steveh78/Upper-Limb-Rehabilitation-Robot/README.md

# ⚙️ Upper limb rehabilitation robot

#### It is a rehabilitation robot for upper limb strength training, specifically rotational and translational movements.

<br> 

## File description

- 📂 firmware : stm32 project files, program manual(korean)
- 📂 hardware : circuit diagram, hardware manual(korean)

<br>

## Overview of research and development
### 1. Introduction
- Upper limb strength training is important for daily life and conservative treatment for patients with spinal cord injuries.
- Rotational exercises strengthen the muscles for wheelchair handling.
- Translational exercises strengthen the pushing and pulling muscles necessary for daily activities.

### 2. Design of mechanical parts
- Mechanism layout
mechanism

### 3. Design of controller
- Block diagram
blockdiagram

- Circuit diagram [hardware](https://github.com/steveh78/Upper-Limb-Rehabilitation-Robot/blob/main/hardware/circuit_diagram.pdf)

circuit

### 4. Control program development
- Function : It consists of 2 exercise modes, 2 option modes, and 3 levels.

|exercise mode|option mode|level|
| --- | --- | --- |
| Rotational | Active-assist | 1, 2, 3 |
| Rotational | Resist | 1, 2, 3 |
| Translational | Active-assist | 1, 2, 3 |
| Translational | Resist | 1, 2, 3 |

- Exercise modes : Rotational and Translational exercise mode
exercisemodes

- Active-assist mode : It operates a motor to assist with exercise. It can also be used for muscle relaxation.
- Resist mode : It uses a motor to generate physical load for muscle strengthening.
- Levels : Exercise intensity can be adjusted in three levels : low(1), medium(2), and high(3).

#### 1. Rotational Active-assist mode
- Controls the position of the AC servo motor by inputting a pulse signal into the AC servo amplifier.
- It waits in a stationary state, and the motor rotates when a value exceeding a certain threshold is measured by the torque sensor.
- If the torque value is high, it indicates that the user is pushing with force, so the position is moved further.
- If the torque value is below a certain threshold, it returns to a stationary state.
- The threshold is set differently depending on the level.

#### 2. Rotational Resist mode 
- It applies the DAC (Digital-to-Analog Converter) voltage to the AC servo amplifier to control the motor current and generate a load.
- The load is set differently depending on the level.
- If a high load is required, use a magnetic brake to generate additional load.
- To prevent the motor from returning to the origin, clear the position deviation to change the origin.

#### 3. Translational Active-assist mode 
- It waits in a stationary state, and the actuator operates when the force sensor measures a value exceeding the threshold.
- The threshold is set differently depending on the level.
translation

#### 4. Translational Resist mode 
- Like Active-assist, it operates the linear actuator by detecting the reaction force applied to the load cell.
- The force threshold and load are set differently depending on the level.
- If the current applied to the motor is high, the load is reduced, making it easier for the user to move. 
- Conversely, if the applied current is low, the load increases, making movement difficult.
<br>

## Result
### 1. Mechanical and electrical parts
prototype

### 2. Control program demonstration
- Rotational exercise

https://github.com/user-attachments/assets/485c6ffb-251e-47c3-863d-0abb0da30623

- Translational exercise

https://github.com/user-attachments/assets/796c5b0c-4be0-4acf-b622-3749bd903251
