steveh78/Upper-Limb-Rehabilitation-Robot/hardware/circuit_diagram.pdf

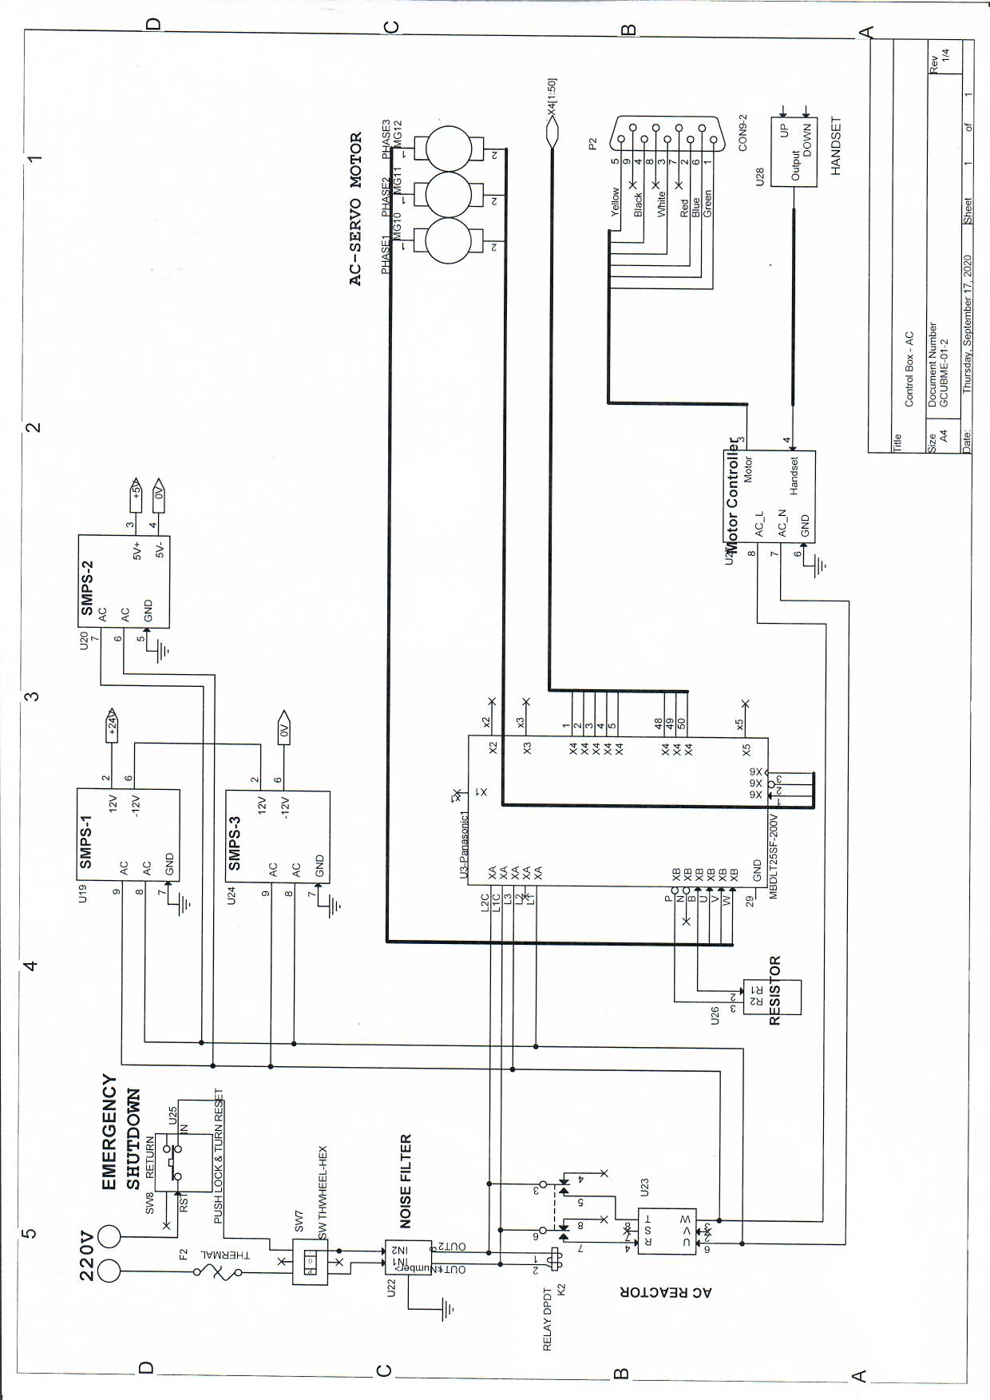
[picture p1: page 1]
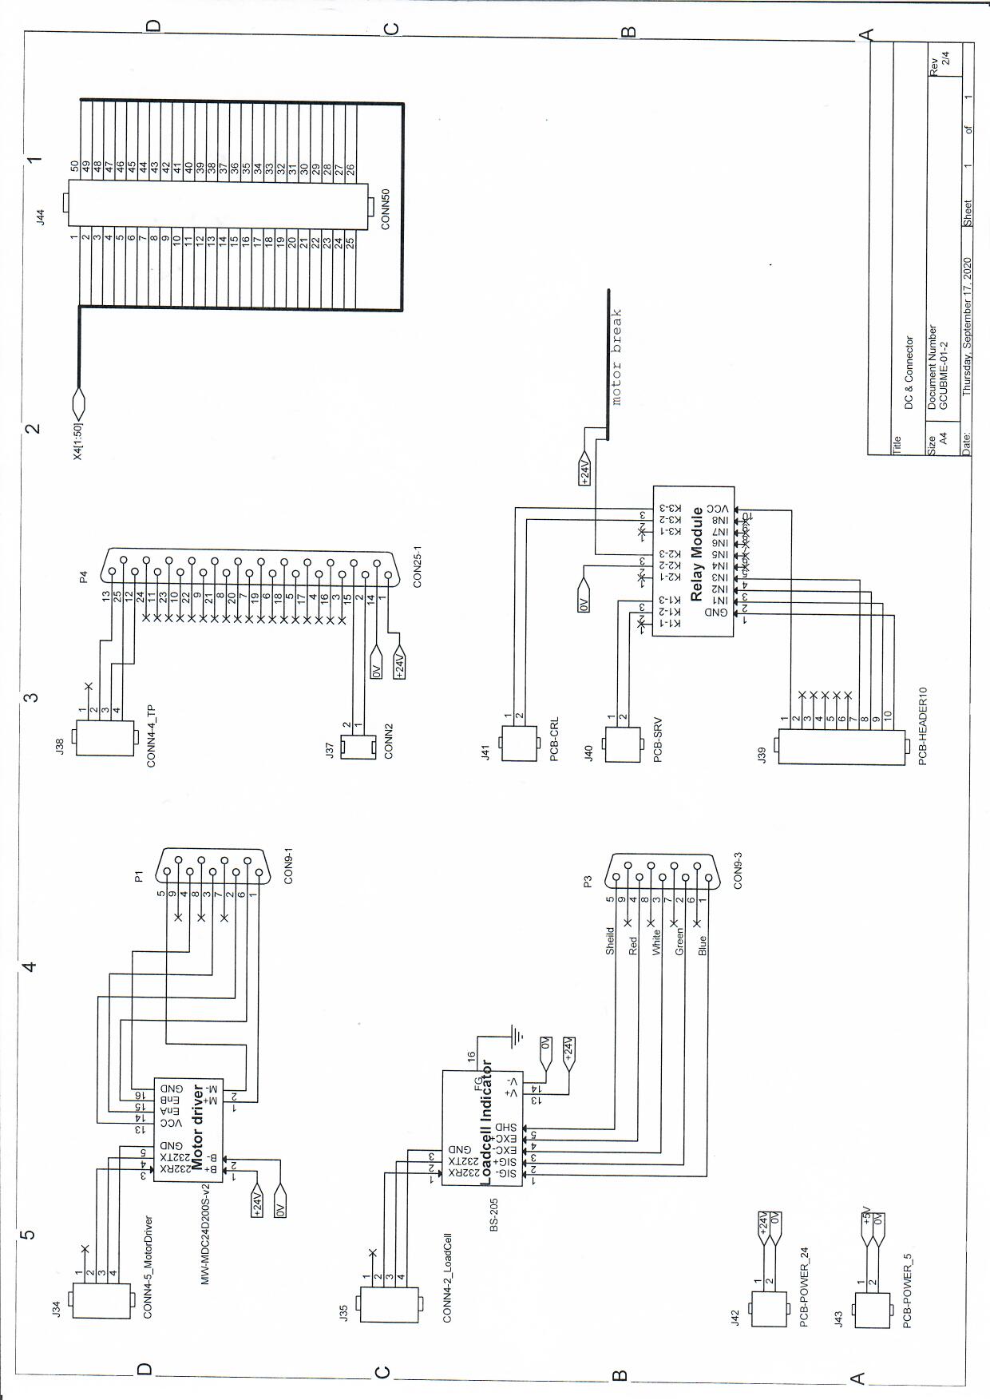
[picture p2: page 2]
