steveh78/Upper-Limb-Rehabilitation-Robot/hardware/hardware_manual_korean.pdf

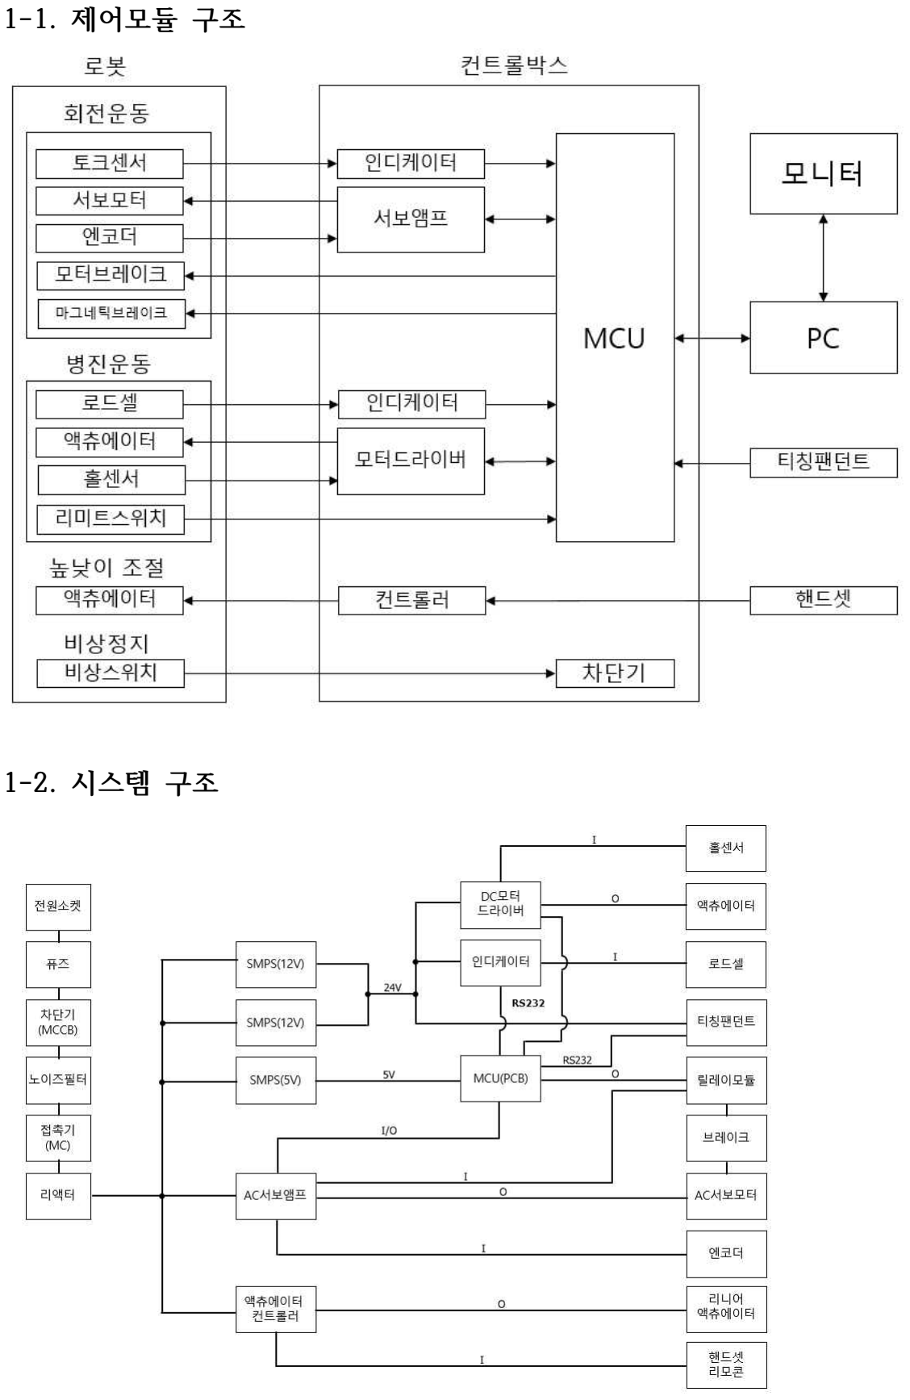
[picture p3: page 1]

### 1-1. 제어모듈 구조

### 1-2. 시스템 구조

### 2. 제작부품 목록

품목 | 모델명 | 규격 | 수 량 | 용도
배선용차단기 | ABE33Fb | 10A / 3P | 1 | 과전류차단
전자접촉기 | DMC22b | AC220V, 20A / 1a1b | 1 | 회로개폐
비상스위치 | PR-25ER | 25파이 | 1 | 비상스위치
소켓 | SS-120BEL | AC250V, 10A / 40*27 | 1 | 전원케이블 연결
퓨즈 | FA-02H | 10A / 5*20 | 1 | 퓨즈
SMPS(5V) | UP50DAA | 50W, DC5V, 8A | 1 | DC 5V
SMPS(12V) | S-350W-12V | 350W, DC12V | 2 | DC 12V, DC 24V
릴레이 모듈 | SZH-RLBG-009 | 8ch / DC5V | 1 | 회로개폐
마이크로컨트롤러 | NUCLEO-F429ZI | Cortex M4 / 180MHz / 144pin | 1 | 모듈 제어
티칭팬던트 | DTP3 | | 1 | 사용자 I/F
AC서보모터 | MSMF042L1T2 | A6, 400W | 1 | 회전운동
AC서보앰프 | MBDLT25SF | A6, AC 250V | 1 | 서보모터 제어모듈
회생저항기 | MCRA-100 | 100W | 1 | 모터과부하 방지
리액터 | WYACR2-0.75 | 400W, AC200V | 1 | 고조파 방지
노이즈필터 | WYNF-S06T2M | AC250V, 6A | 1 | 노이즈필터
리니어액츄에이터 | TA2P | DC24V / 4A(max) / 300mm stroke | 2 | 병진운동
컨트롤러 | TC2B | AC220V, 30A | 1 | 높낮이조절 리모콘
모터드라이버 | MW-MDC24D200 D | 10A / 8~30A | 1 | 리니어액츄에이터 제어모듈
로드셀 | DBBP-50 | 50kg(max) | 1 | 압력측정
인디케이터 | BS-205 | DC24V, RS232 | 1 | ADC, 측정값 전송
회전토크센서 | BRDM-N-100 | 100Nm(max) | 1 | 토크측정
인디케이터 | BS-3520 | AC220V, RS232 | 1 | ADC, 측정값 전송

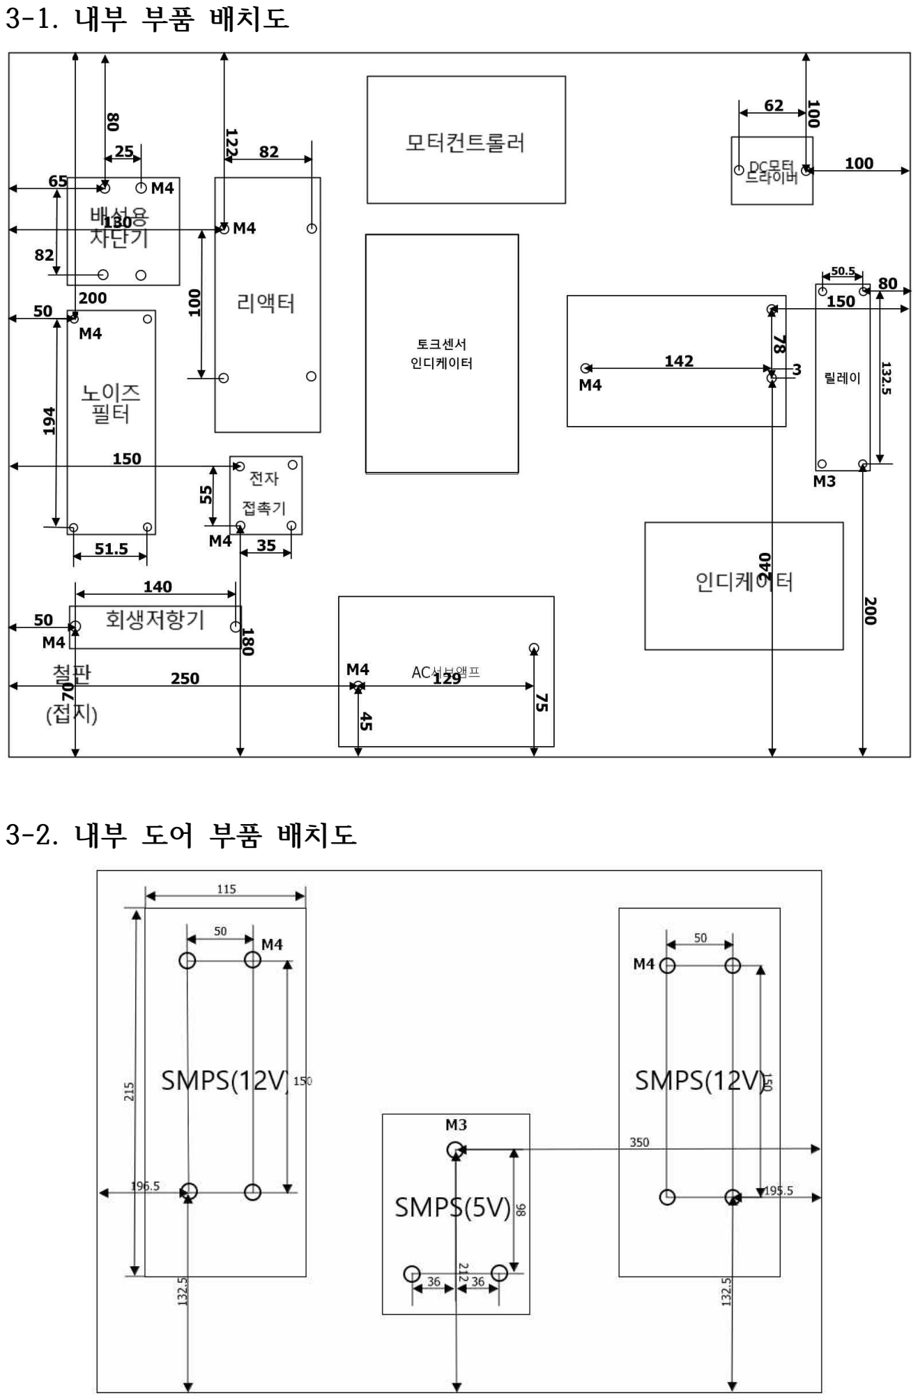
[picture p4: page 3]

### 3-1. 내부 부품 배치도

### 3-2. 내부 도어 부품 배치도

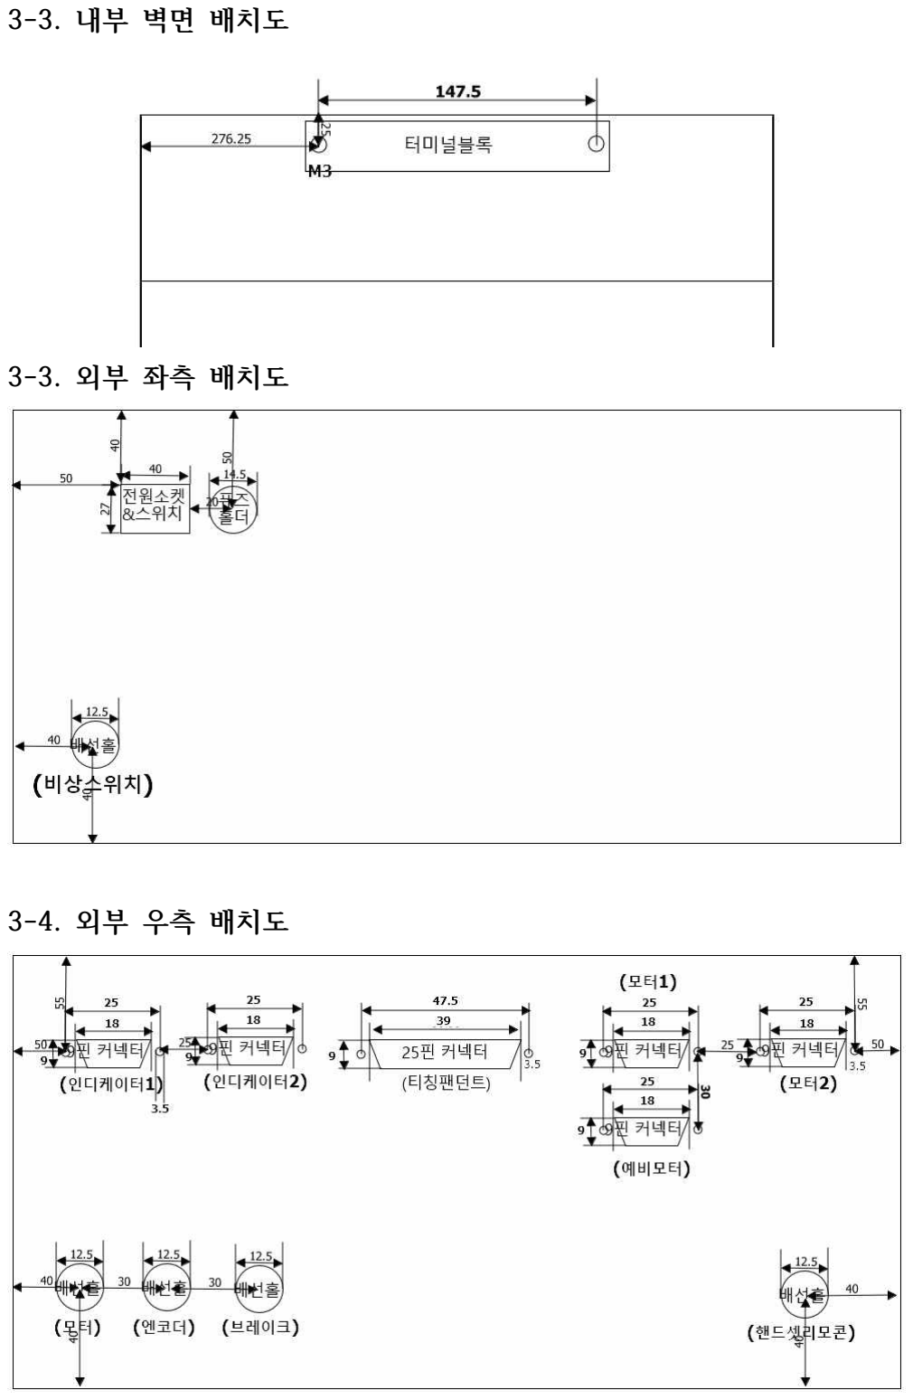
[picture p5: page 4]

### 3-3. 내부 벽면 배치도

### 3-3. 외부 좌측 배치도

### 3-4. 외부 우측 배치도

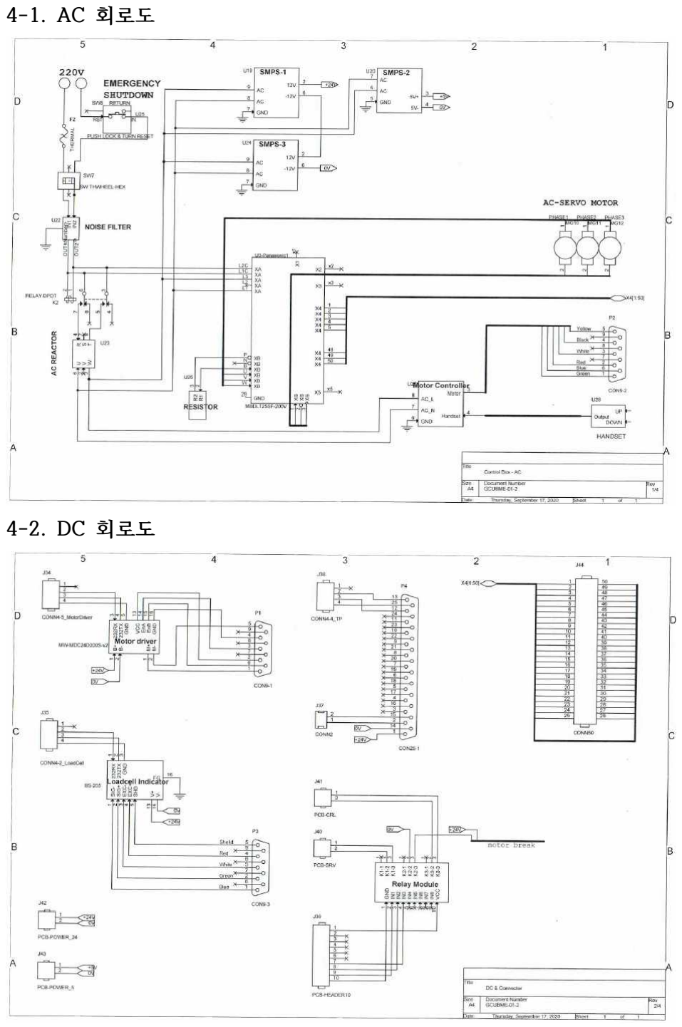
[picture p6: page 5]

### 4-1. AC 회로도

### 4-2. DC 회로도

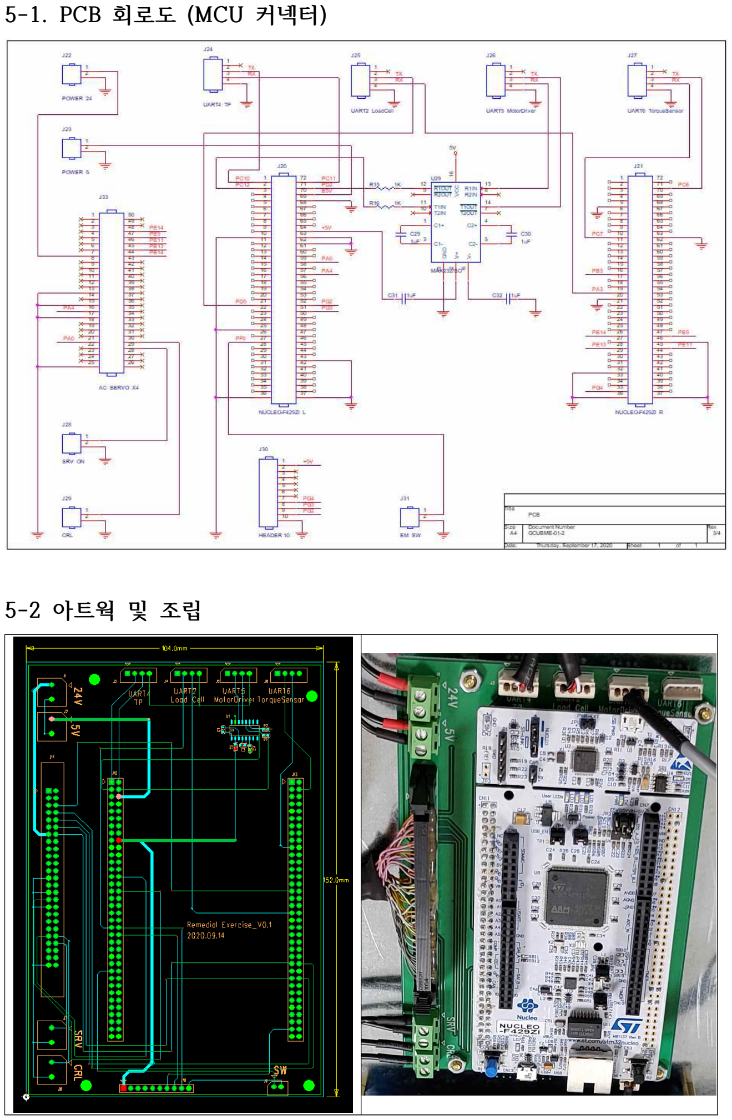
[picture p7: page 6]

### 5-1. PCB 회로도 (MCU 커넥터)

### 5-2 아트웍 및 조립

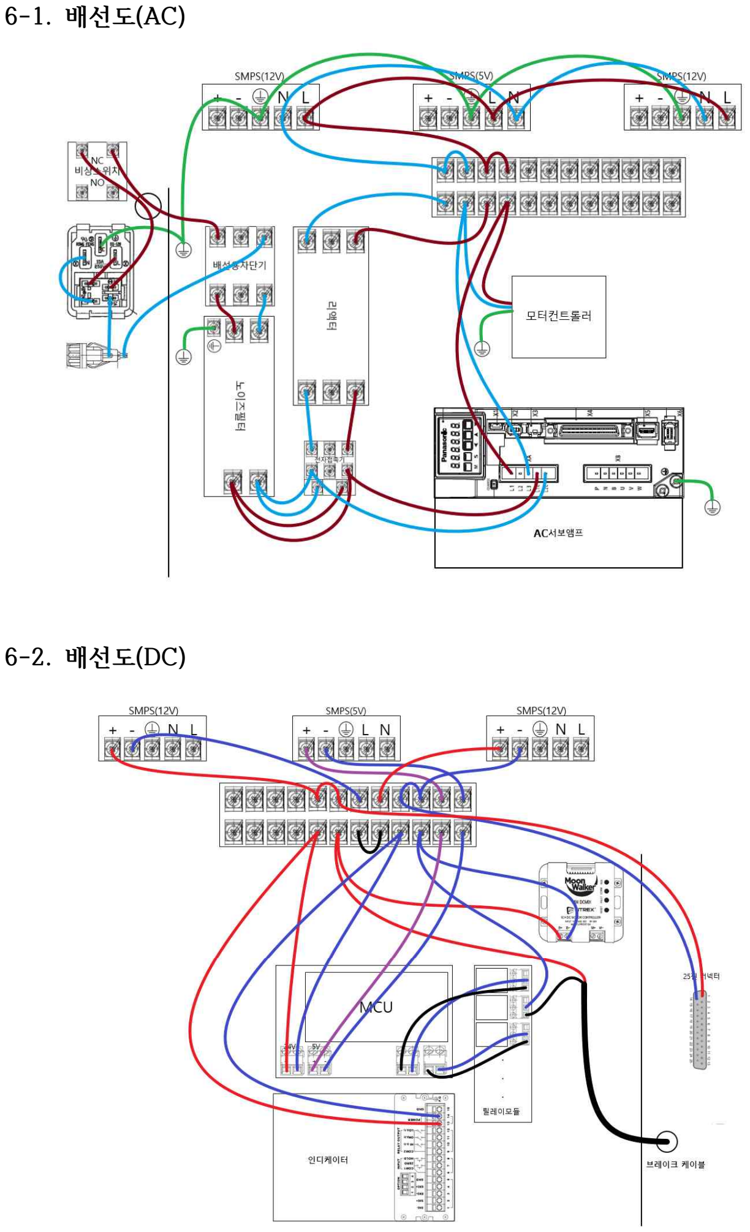
[picture p8: page 7]

### 6-1. 배선도(AC)

### 6-2. 배선도(DC)

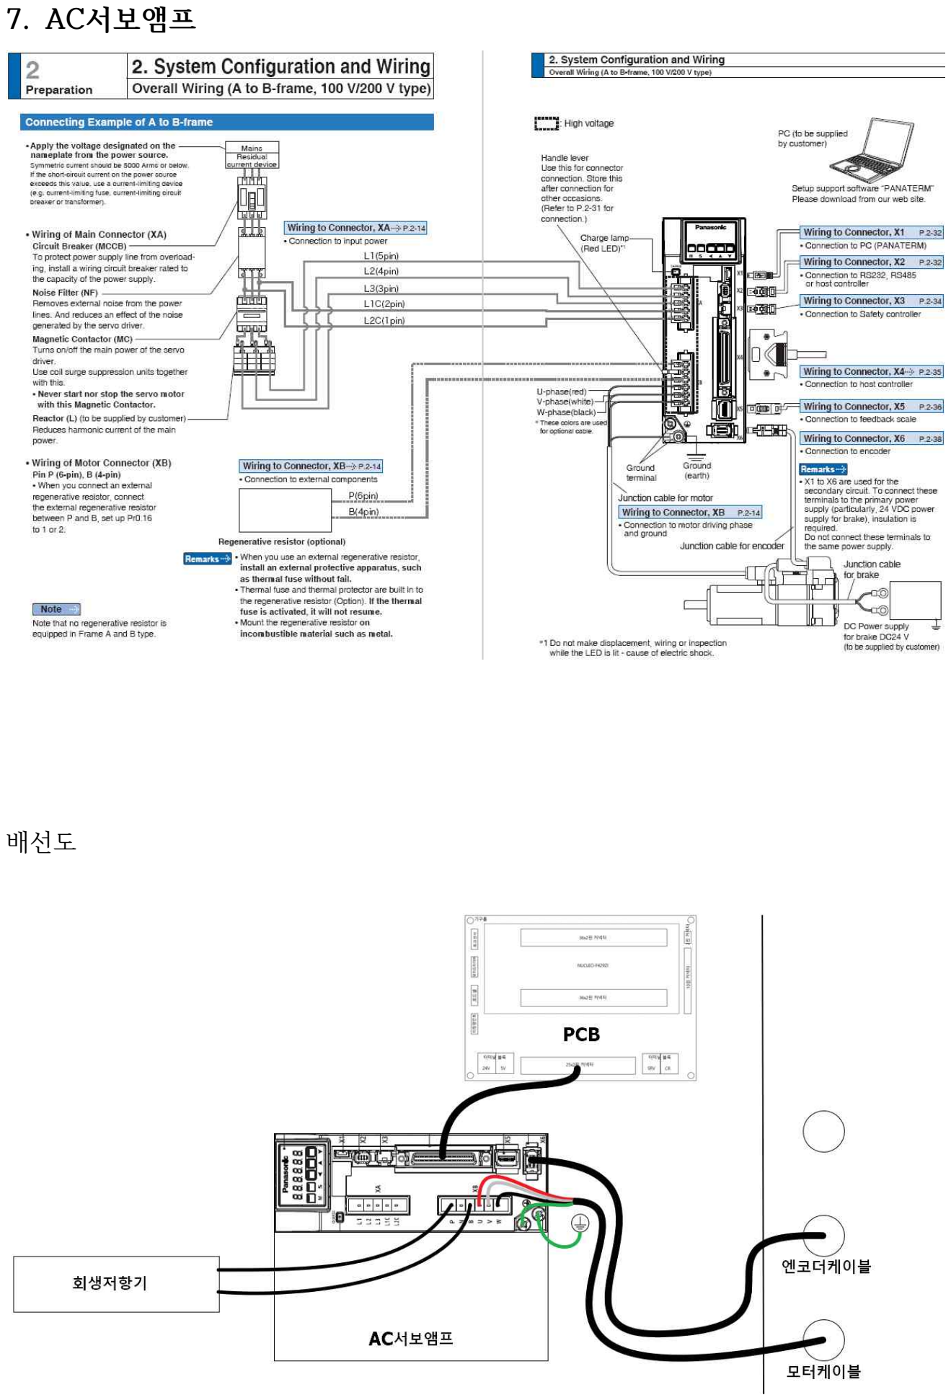
[picture p9: page 8]

### 7. AC서보앰프

배선도

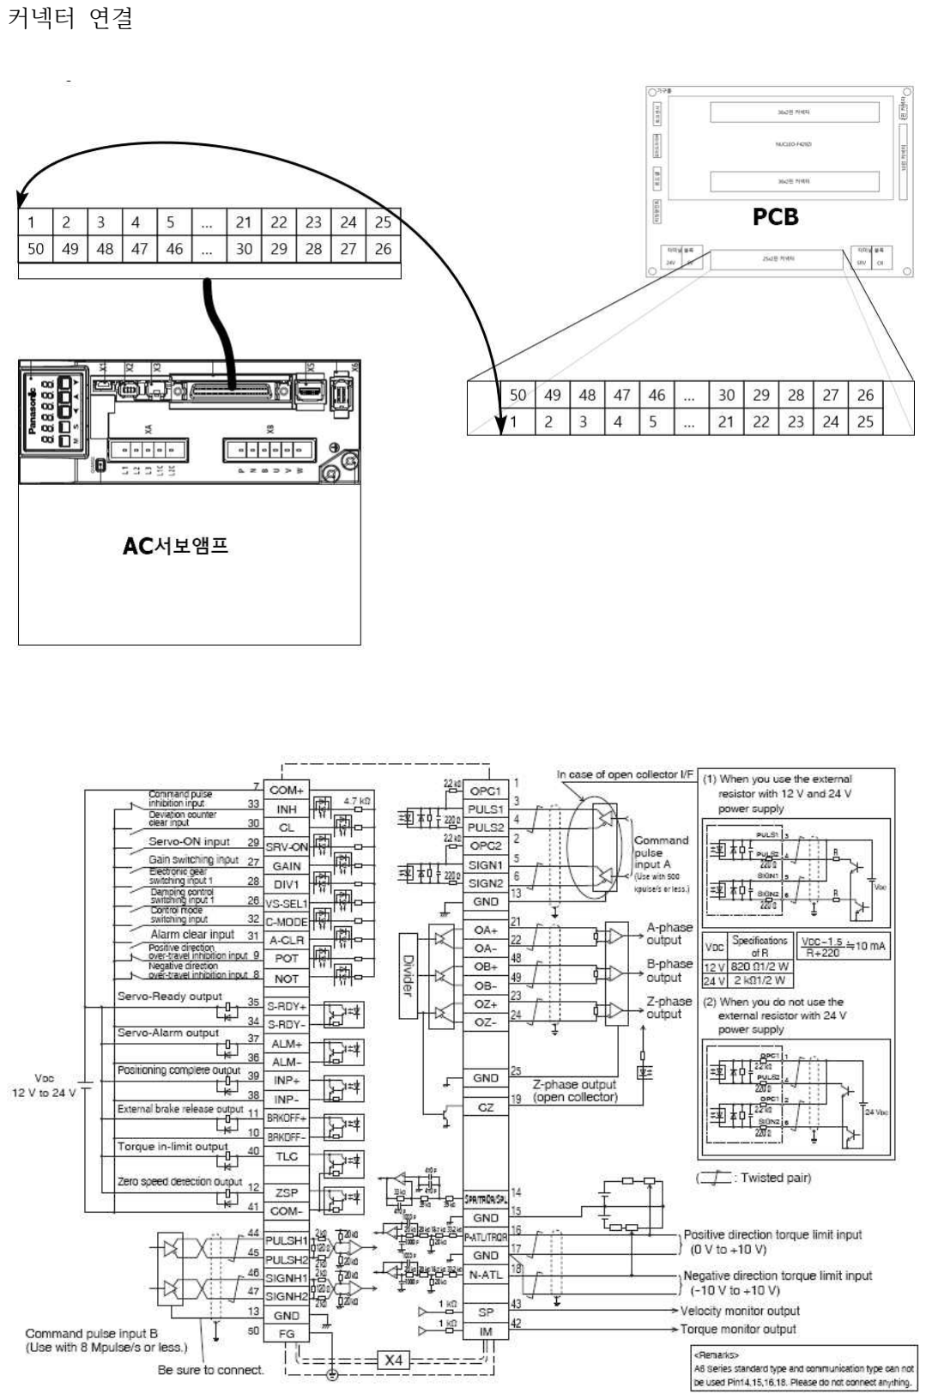
[picture p10: page 9]

커넥터 연결

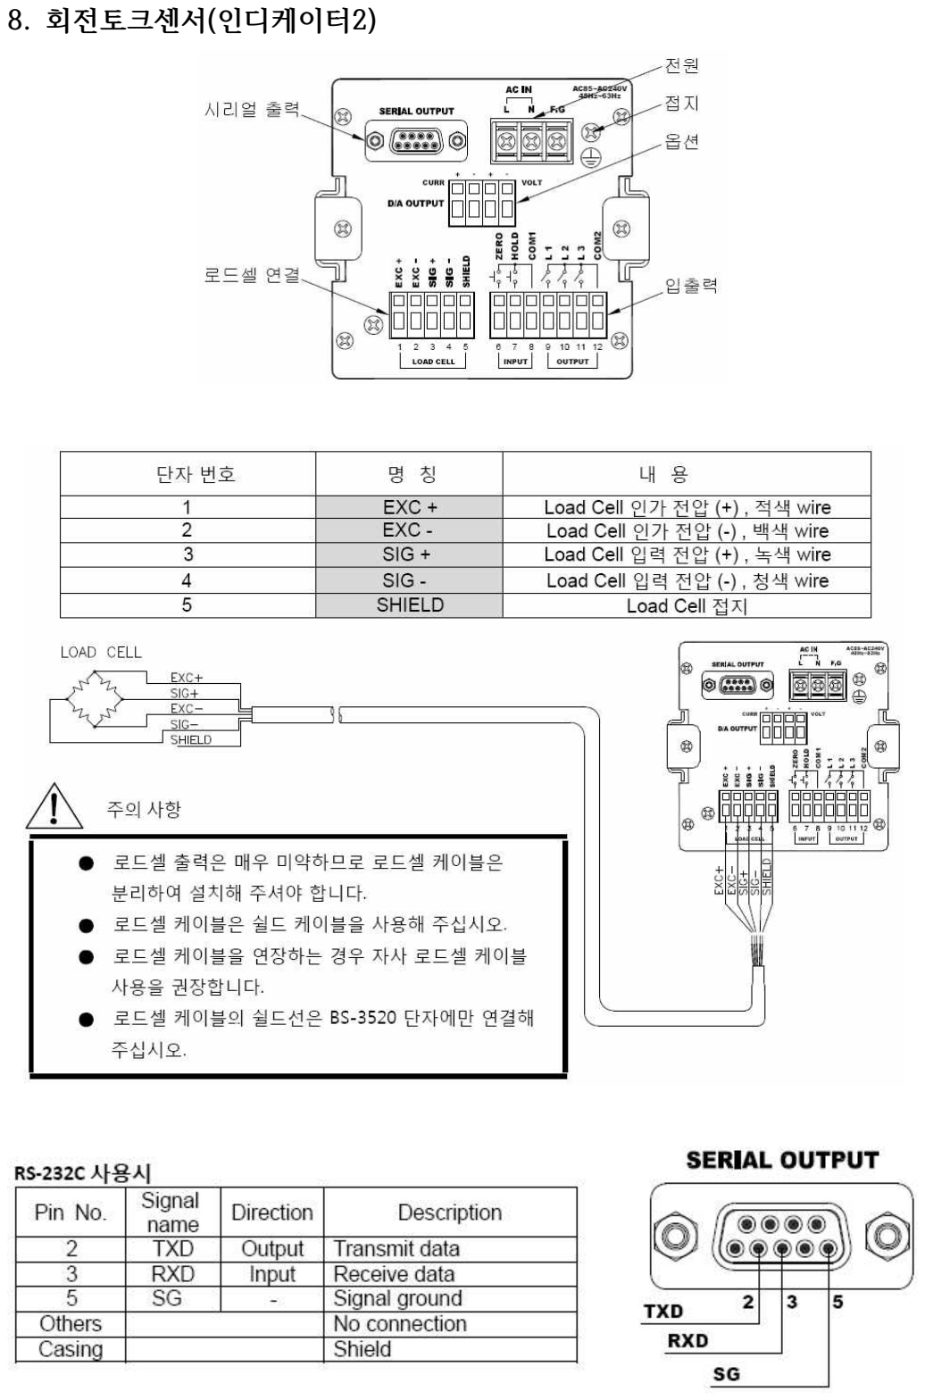
[picture p11: page 10]

### 8. 회전토크센서(인디케이터2)

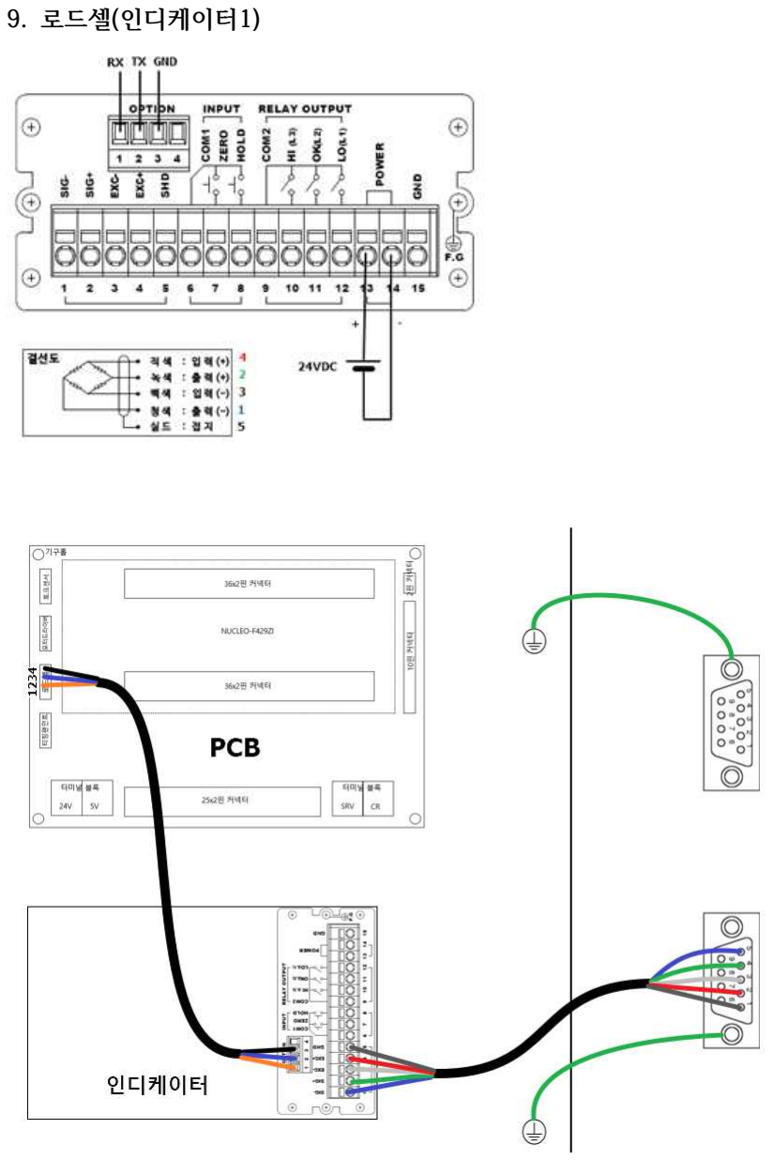
[picture p12: page 11]

### 9. 로드셀(인디케이터1)

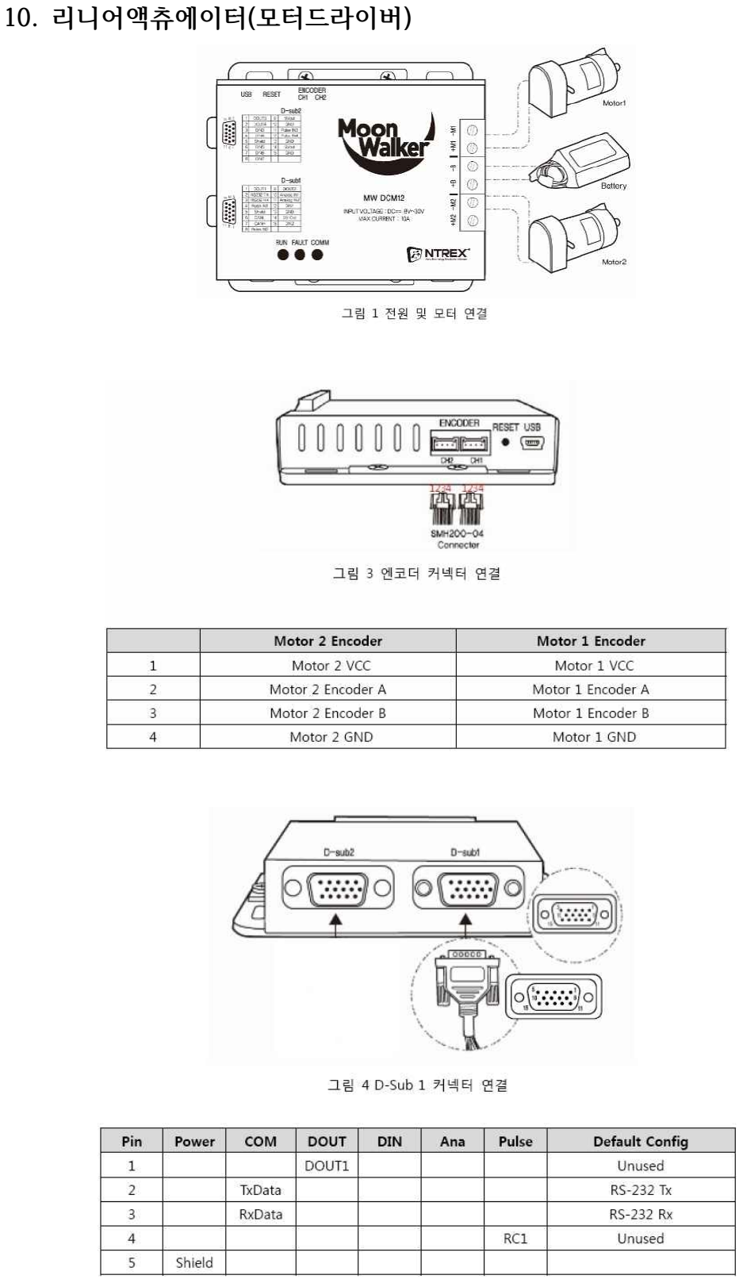
[picture p13: page 12]

### 10. 리니어액츄에이터(모터드라이버)

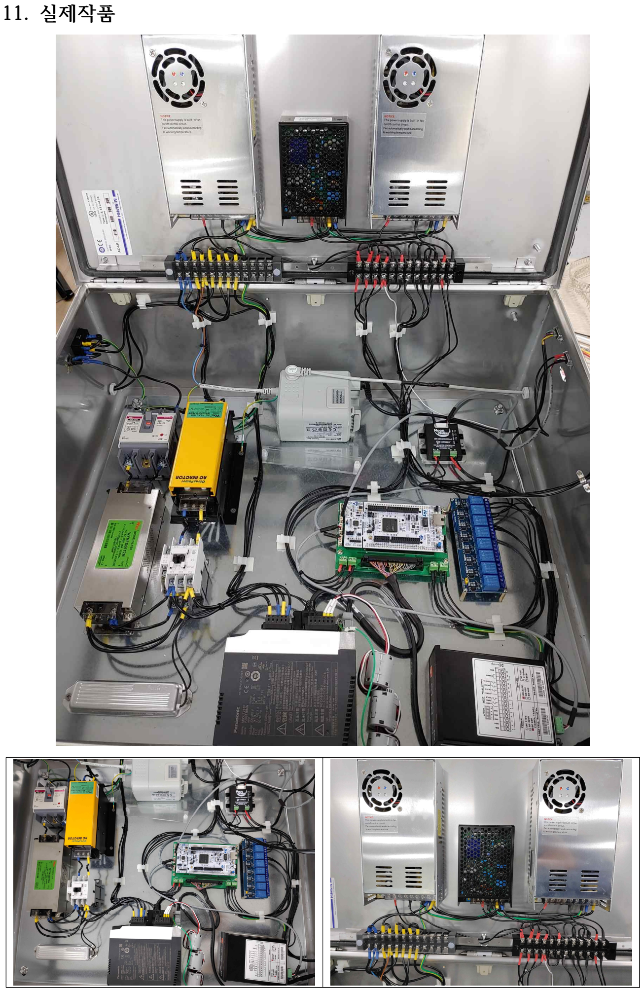
[picture p14: page 13]

### 11. 실제작품
