steveh78/Upper-Limb-Rehabilitation-Robot/(commit log)

2026-03-25 Update README with Translational Resist mode details
    Added details about the Translational Resist mode and clarified thresholds for various modes.
2026-03-25 Fix formatting in README for magnetic brake description
2026-04-06 Add link to circuit diagram in README
